marcocipriani01/Bachelor-Thesis/STM32F411/Black Pill pinout 1.jpg

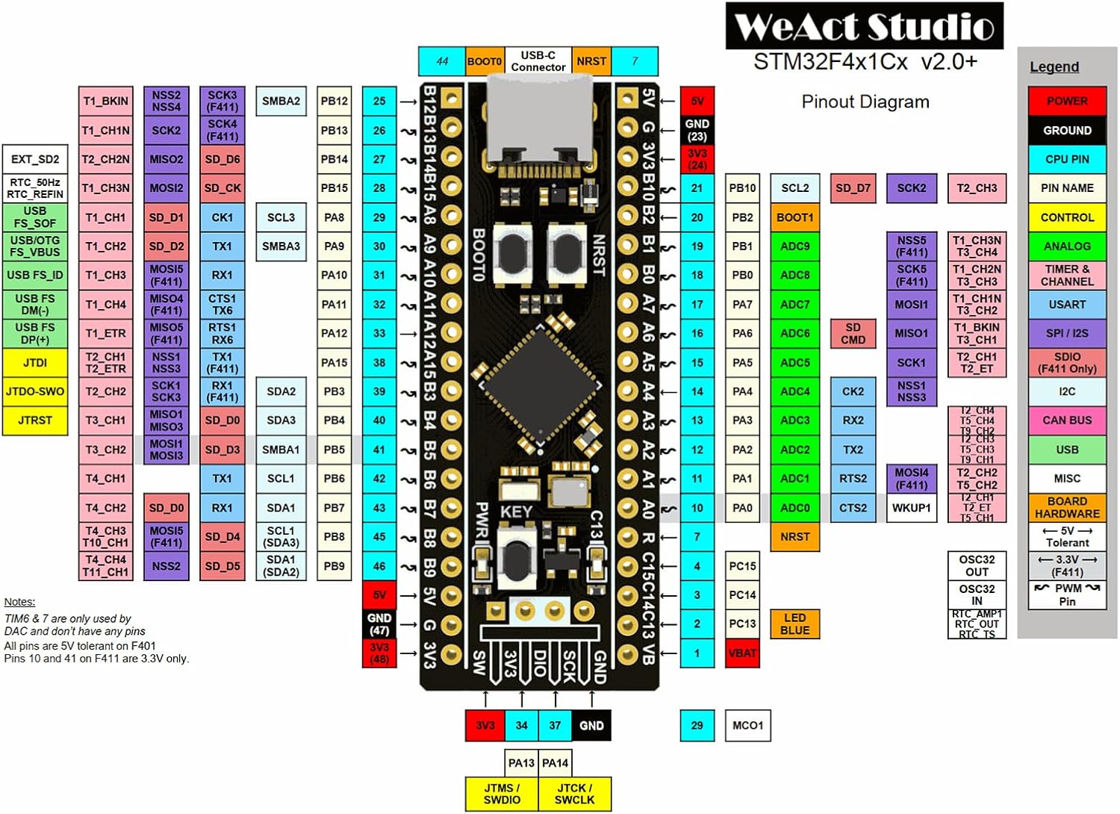
STM32F411/Black Pill pinout 1.jpg
