marcocipriani01/Bachelor-Thesis/README.md

# Bachelor thesis

My thesis for the bachelor in Electronics Engineering at the University of Rome "La Sapienza".

See file `Tesi di Laurea - Marco Cipriani.docx`.

The firmware for the STM32F411-based prototype can be found in the `Firmware` folder.
It can be compiled using _STM32CubeIDE_, or using _CMake_ in _Visual Studio Code_ and _JetBrains CLion_.

A version of _CMSIS DSP_ for _Arm Cortex-M4F_ microcontrollers is available in the `CMSIS` folder under as `libCMSISDSP.a`.
