marcocipriani01/Bachelor-Thesis/Presentazione.pptx

## Multimetro digitale basato su microcontrollore STM32 con rilevamento della forma d’onda

Marco Cipriani

Facoltà di Ingegneria dell'informazione, informatica e statistica
Corso di laurea in Ingegneria Elettronica
Relatore: Prof. Emanuele Piuzzi

A.A. 2023-2024

## Slide 2

Titolo Presentazione

Selezionare per scrivere o eliminare il sottotitolo

## Slide 3

Selezionare per scrivere o eliminare il sottotitolo

## Slide 4

Selezionare per scrivere o eliminare il sottotitolo

## Slide 5

Selezionare per scrivere o eliminare il sottotitolo

## Slide 6

Selezionare per scrivere o eliminare il sottotitolo
