marcocipriani01/Bachelor-Thesis/Op amp/2502.Drawing1.jpg-550x0.jpg

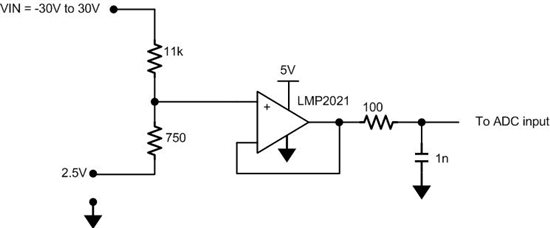
Op amp/2502.Drawing1.jpg-550x0.jpg
