marcocipriani01/Bachelor-Thesis/Op amp/ePYbW.png

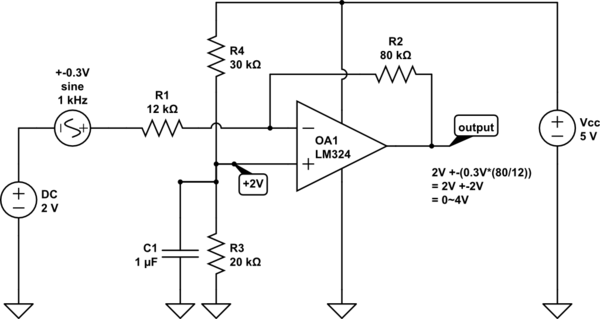
Op amp/ePYbW.png
