marcocipriani01/Bachelor-Thesis/Op amp/GIv9u.jpg

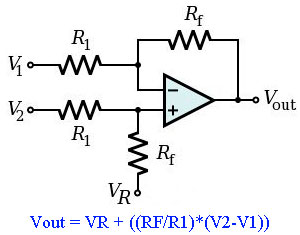
Op amp/GIv9u.jpg
