marcocipriani01/Bachelor-Thesis/Op amp/Screenshot 2024-08-02 210748.png

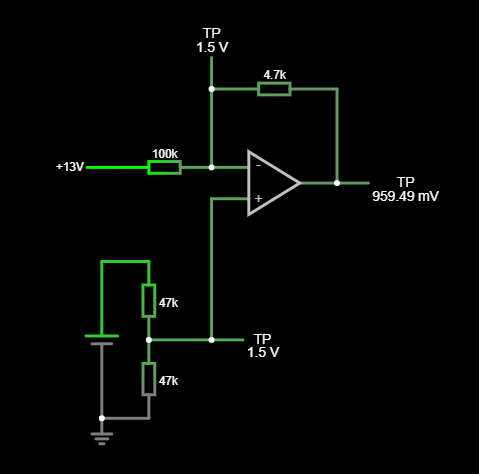
Op amp/Screenshot 2024-08-02 210748.png
