marcocipriani01/Bachelor-Thesis/Pictures and diagrams/Condizionamento segnale.png

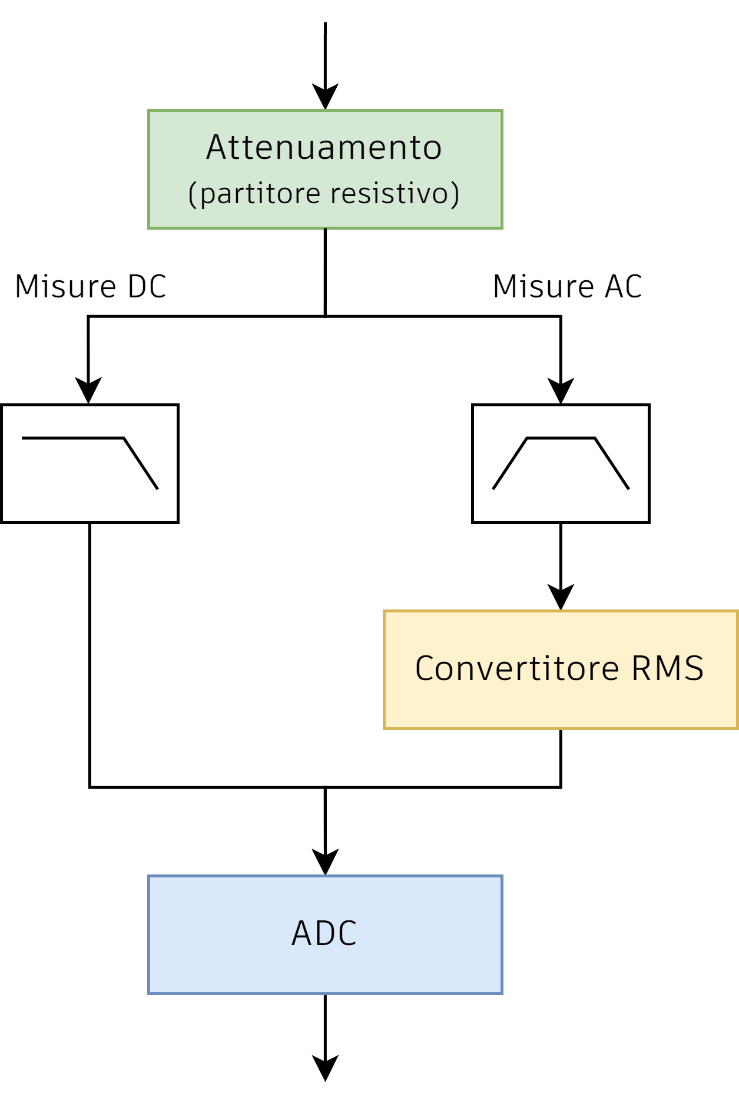
Pictures and diagrams/Condizionamento segnale.png
