marcocipriani01/Bachelor-Thesis/Firmware/Core/Src/main.c

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
/* Includes ------------------------------------------------------------------*/
#include "main.h"
#include "usb_device.h"

/* USER CODE BEGIN Includes */
#include "dmm_dsp.h"
#include <stdint.h>
/* USER CODE END Includes */

/* USER CODE BEGIN PM */
#define ADC_RESOLUTION 12
#define ADC_MAX_VALUE 4096
#define ADC_VREF 3.3f
#define ADC_R1 100000.0f
#define ADC_Rf 4700.0f
#define ADC_TO_VOLTAGE ((ADC_VREF / ADC_MAX_VALUE) * (-ADC_R1 / ADC_Rf))
#define ADC_OFFSET (((ADC_VREF / 2.0f) * ADC_Rf / ADC_R1) * (ADC_MAX_VALUE / ADC_VREF) + (ADC_MAX_VALUE / 2.0f))

typedef enum {
  ADC_NOT_READY = 0,
  ADC_BUSY = 1,
  ADC_ERROR = 2,
  ADC_SUCCESS = 3
} ADCStatus;
/* USER CODE END PM */

ADC_HandleTypeDef hadc1;
DMA_HandleTypeDef hdma_adc1;

TIM_HandleTypeDef htim2;

/* USER CODE BEGIN PV */
volatile uint16_t adcData[DMM_BUF_SIZE];
volatile ADCStatus adcStatus = ADC_NOT_READY;
/* USER CODE END PV */

void SystemClock_Config(void);
static void MX_GPIO_Init(void);
static void MX_DMA_Init(void);
static void MX_ADC1_Init(void);
static void MX_TIM2_Init(void);
/* USER CODE BEGIN 0 */
void HAL_ADC_ConvCpltCallback(ADC_HandleTypeDef* hadc) {
  HAL_ADC_Stop_DMA(&hadc1);
  adcStatus = ADC_SUCCESS;
}

void HAL_ADC_ErrorCallback(ADC_HandleTypeDef* hadc) {
  adcStatus = ADC_ERROR;
}

static void setSamplingFreq(const float f) {
  const float timFreq = ((float) HAL_RCC_GetPCLK1Freq()) * 2.0f;
  for (unsigned int prescaler = 0; prescaler < USHRT_MAX; prescaler++) {
    const float arrF = (timFreq / ((float) (prescaler + 1) * f)) - 1.0f;
    if ((arrF > 1.0f) && (arrF < (ULONG_MAX - 1.0f))) {
      __HAL_TIM_DISABLE(&htim2);
      __HAL_TIM_SET_COUNTER(&htim2, 0);
      __HAL_TIM_SET_PRESCALER(&htim2, prescaler);
      const uint32_t arr = (uint32_t) roundf(arrF);
      __HAL_TIM_SET_AUTORELOAD(&htim2, arr);
      __HAL_TIM_ENABLE(&htim2);
      return;
    }
  }
}

static float setMeasurementTime(const float t) {
  const float f = DMM_BUF_SIZE / t;
  setSamplingFreq(f);
  return f;
}

static void startSampling() {
  HAL_ADC_Start_DMA(&hadc1, (uint32_t*) adcData, DMM_BUF_SIZE);
  adcStatus = ADC_BUSY;
}
/* USER CODE END 0 */

/**
  * @brief  The application entry point.
  * @retval int
  */
int main(void)
{

  /* MCU Configuration--------------------------------------------------------*/

  /* Reset of all peripherals, Initializes the Flash interface and the Systick. */
  HAL_Init();

  /* Configure the system clock */
  SystemClock_Config();

  /* Initialize all configured peripherals */
  MX_GPIO_Init();
  MX_DMA_Init();
  MX_ADC1_Init();
  MX_USB_DEVICE_Init();
  MX_TIM2_Init();
  /* USER CODE BEGIN 2 */
  float samplingFreq = setMeasurementTime(0.1f);
  HAL_TIM_Base_Start(&htim2);
  //HAL_TIM_OC_Start(&htim2, TIM_CHANNEL_1);

  DMM_DSP_Init(RECT);
  /* USER CODE END 2 */

  /* Infinite loop */
  /* USER CODE BEGIN WHILE */
  while (1) {
    startSampling();
    while (adcStatus == ADC_BUSY) {}
    if (adcStatus != ADC_SUCCESS) continue;

    HAL_GPIO_WritePin(LED_GPIO_Port, LED_Pin, GPIO_PIN_SET);
    const uint32_t start = HAL_GetTick();

    DMM_DSP_AddADCData(adcData, ADC_OFFSET, ADC_TO_VOLTAGE);
    const float32_t* fft = DMM_DSP_Process();

    uint16_t peaks[FFT_PEAKS_MAX];
    const uint16_t peaksCount = DMM_DSP_FindPeaks(peaks);

    const uint16_t fundamentalIdx = DMM_DSP_FindFundamental(peaks, peaksCount);
    const float fundamental = DMM_DSP_IndexToFreq(fundamentalIdx, samplingFreq);
    const Waveform waveform = DMM_DSP_DetectWaveform(fundamentalIdx, peaks, peaksCount);

    printf(">W%d\n", (int) waveform);
    printf(">m%.3f\n", DMM_DSP_GetMin());
    printf(">M%.3f\n", DMM_DSP_GetMax());
    printf(">A%.3f\n", DMM_DSP_GetAvg());
    printf(">R%.3f\n", DMM_DSP_GetRMS());
    printf(">f%.3f\n", fundamental);
    printf(">T%.3f\n", 1000.0f / fundamental);
    printf(">a%.3f\n", 2.0f * fft[fundamentalIdx]);
    printf(">p%d\n", HAL_GetTick() - start);

    uint8_t c;
    int sampleTime;
    if (RingBuffer_Pop(&cdcRxRingBuff, &c) && (c == '>') &&
        RingBuffer_Pop(&cdcRxRingBuff, &c) && (c == 'S') &&
        RingBuffer_ReadInt(&cdcRxRingBuff, &sampleTime) && (sampleTime > 1) && (sampleTime < 2000)) {
      samplingFreq = setMeasurementTime((float) sampleTime / 1000.0f);
    }

    HAL_GPIO_WritePin(LED_GPIO_Port, LED_Pin, GPIO_PIN_RESET);
    HAL_Delay(100);
    /* USER CODE END WHILE */

    /* USER CODE BEGIN 3 */
  }
  /* USER CODE END 3 */
}

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
/* USER CODE BEGIN 4 */
int _write(int file, char *ptr, int len) {
  // See https://github.com/alexeykosinov/Redirect-printf-to-USB-VCP-on-STM32H7-MCU
  if (!MX_USB_DEVICE_Connected())
    return 0;
  const uint8_t res = CDC_Transmit_FS((uint8_t*) ptr, len);
  return (res == USBD_OK) ? len : 0;
}
/* USER CODE END 4 */
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
