marcocipriani01/Bachelor-Thesis/Firmware/Firmware.ioc

Mcu.UserName=STM32F411CEUx
PA0-WKUP.GPIO_Label=KEY
PA0-WKUP.Signal=GPIO_Input
PA1.GPIO_Label=SIG_IN
PA1.Signal=ADCx_IN1
PA11.GPIO_Label=USB_DN
PA11.Signal=USB_OTG_FS_DM
PA12.GPIO_Label=USB_DP
PA12.Signal=USB_OTG_FS_DP
PA13.GPIO_Label=SWIO
PA13.Signal=SYS_JTMS-SWDIO
PA14.GPIO_Label=SWCLK
PA14.Signal=SYS_JTCK-SWCLK
PA5.Signal=S_TIM2_CH1_ETR
PC13-ANTI_TAMP.GPIO_Label=LED
PC13-ANTI_TAMP.Signal=GPIO_Output
PC14-OSC32_IN.Signal=RCC_OSC32_IN
PC15-OSC32_OUT.Signal=RCC_OSC32_OUT
