marcocipriani01/Bachelor-Thesis/Firmware/Core/Inc/main.h

#define LED_Pin GPIO_PIN_13
#define LED_GPIO_Port GPIOC
#define KEY_Pin GPIO_PIN_0
#define KEY_GPIO_Port GPIOA
#define SIG_IN_Pin GPIO_PIN_1
#define SIG_IN_GPIO_Port GPIOA
#define USB_DN_Pin GPIO_PIN_11
#define USB_DN_GPIO_Port GPIOA
#define USB_DP_Pin GPIO_PIN_12
#define USB_DP_GPIO_Port GPIOA
#define SWIO_Pin GPIO_PIN_13
#define SWIO_GPIO_Port GPIOA
#define SWCLK_Pin GPIO_PIN_14
#define SWCLK_GPIO_Port GPIOA
